fre69/voiture-rc/bras_v4_eezybot/stl_original/docs_images/b436ef58e6b25d29e519d9658bfed57a.png

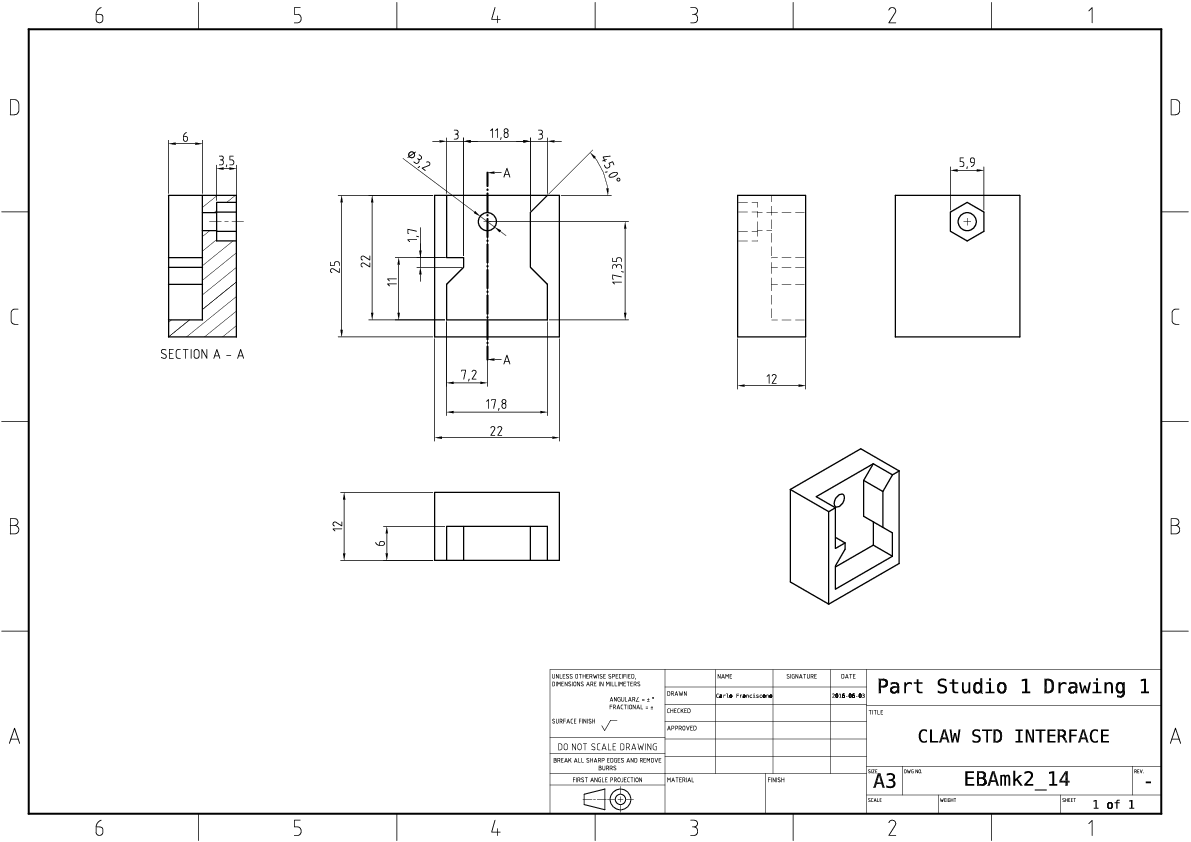
bras_v4_eezybot/stl_original/docs_images/b436ef58e6b25d29e519d9658bfed57a.png
