fre69/voiture-rc/bras_v4_eezybot/stl_original/print/EBAmk2_018_claw_gear_driven.STL

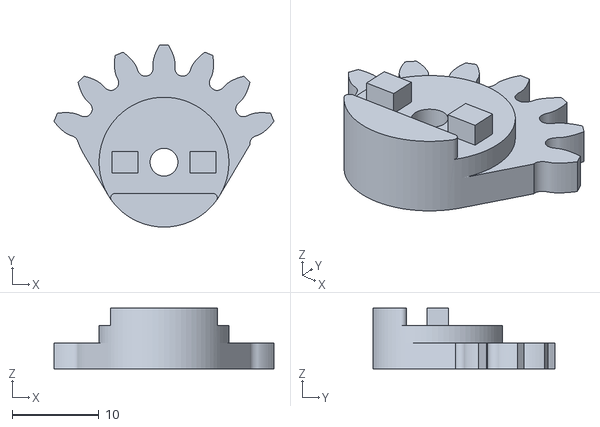
[picture p2: CAD file, 2026-04-28]
bras_v4_eezybot/stl_original/print/EBAmk2_018_claw_gear_driven.STL
25.3 x 21.0 x 7.00
