fre69/voiture-rc/bras_v4_eezybot/stl_original/skip/EBAmk2_013_lower_base.STL

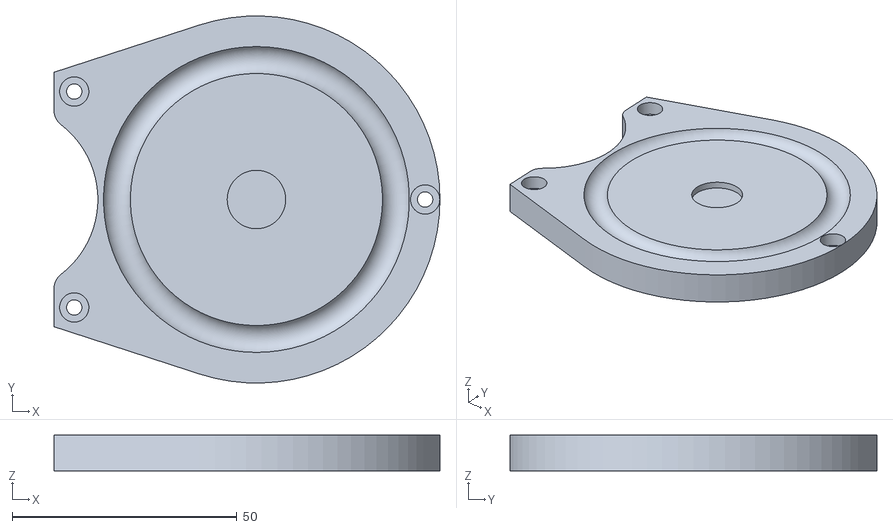
[picture p3: CAD file, 2026-04-28]
bras_v4_eezybot/stl_original/skip/EBAmk2_013_lower_base.STL
85.8 x 81.6 x 8.00
