fre69/voiture-rc/stl/biellette.stl

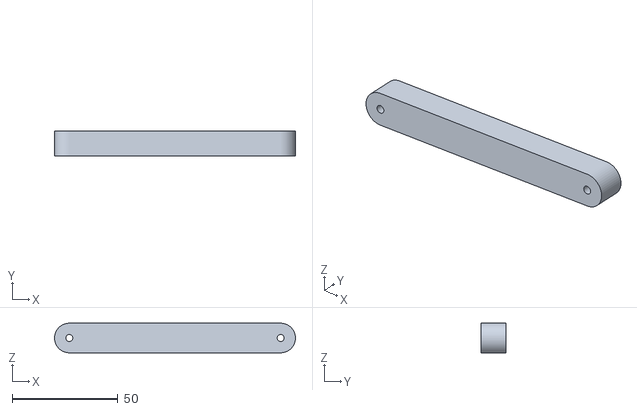
[picture p4: CAD file, 2026-04-23]
stl/biellette.stl
114.0 x 12.0 x 14.0
