fre69/voiture-rc/bras_v4_eezybot/stl_original/print/EBAmk2_016_claw_gear_drive.STL

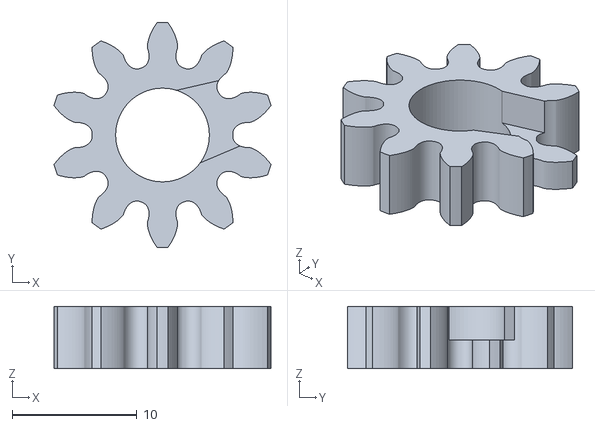
[picture p5: CAD file, 2026-04-28]
bras_v4_eezybot/stl_original/print/EBAmk2_016_claw_gear_drive.STL
17.4 x 18.0 x 5.00
