fre69/voiture-rc/bras_v4_eezybot/stl_original/skip/EBAmk2_019_drive_cover.STL

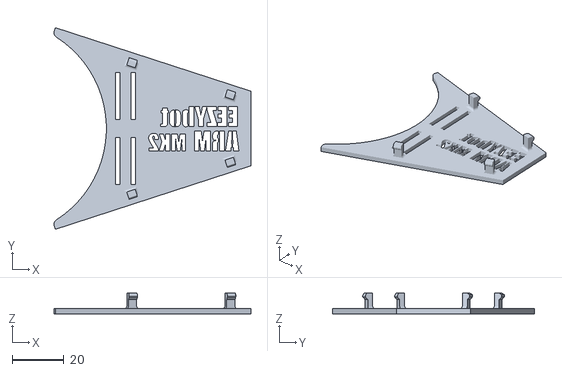
[picture p6: CAD file, 2026-04-28]
bras_v4_eezybot/stl_original/skip/EBAmk2_019_drive_cover.STL
76.3 x 78.1 x 8.00
