fre69/voiture-rc/stl/pince_corps.stl

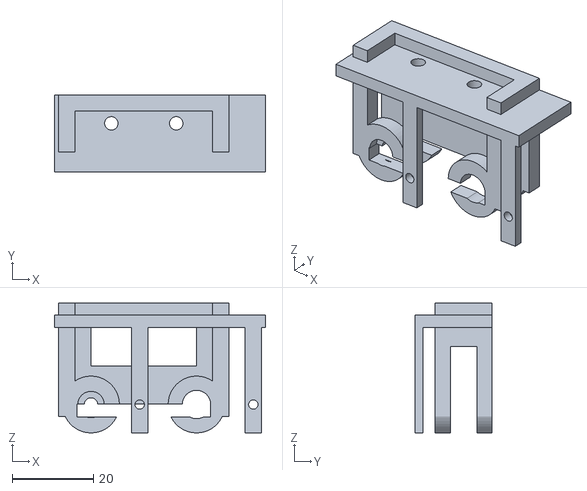
[picture p7: CAD file, 2026-04-23]
stl/pince_corps.stl
52.0 x 19.0 x 32.0
