fre69/voiture-rc/bras_v4_eezybot/stl_original/print/EBAmk2_014_claw_base.STL

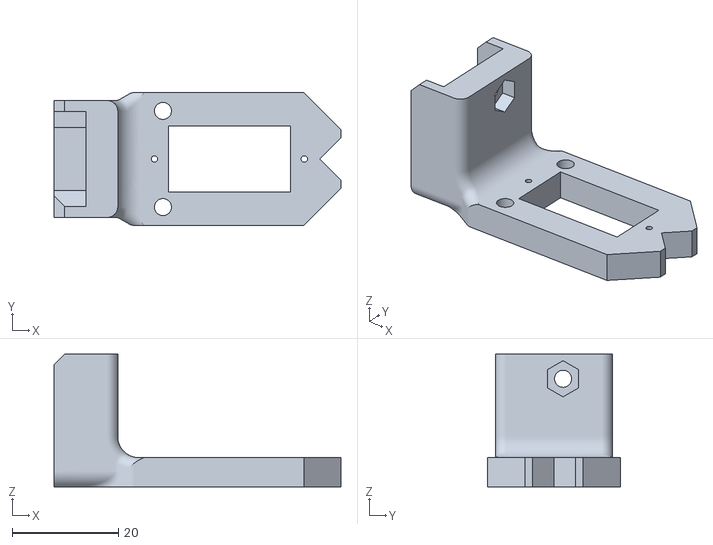
[picture p8: CAD file, 2026-04-28]
bras_v4_eezybot/stl_original/print/EBAmk2_014_claw_base.STL
54.0 x 25.0 x 25.0
