fre69/voiture-rc/stl/machoire_droite.stl

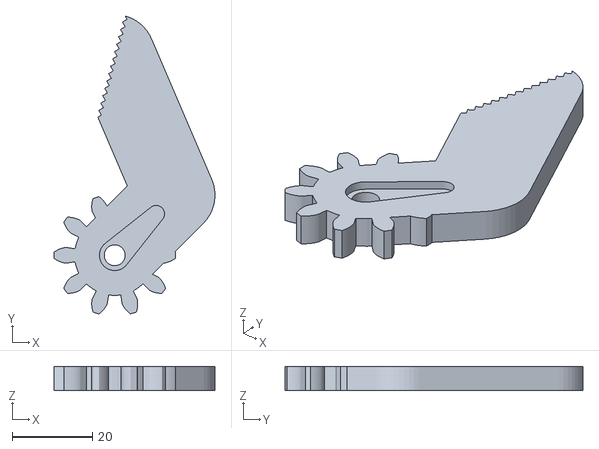
[picture p9: CAD file, 2026-04-23]
stl/machoire_droite.stl
40.1 x 74.3 x 6.00
