fre69/voiture-rc/bras_v4_eezybot/stl_original/print/EBAmk2_017_claw_finger_sx.STL

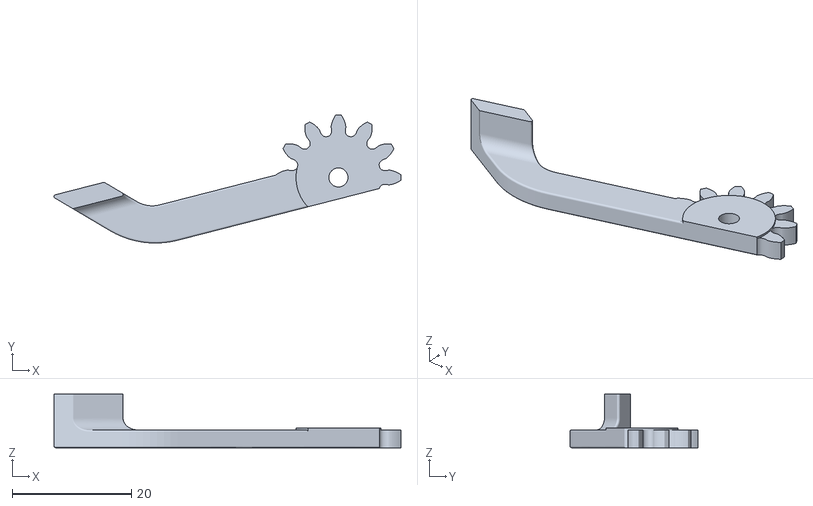
[picture p10: CAD file, 2026-04-28]
bras_v4_eezybot/stl_original/print/EBAmk2_017_claw_finger_sx.STL
58.3 x 21.5 x 9.00
