fre69/voiture-rc/stl/support_epaule.stl

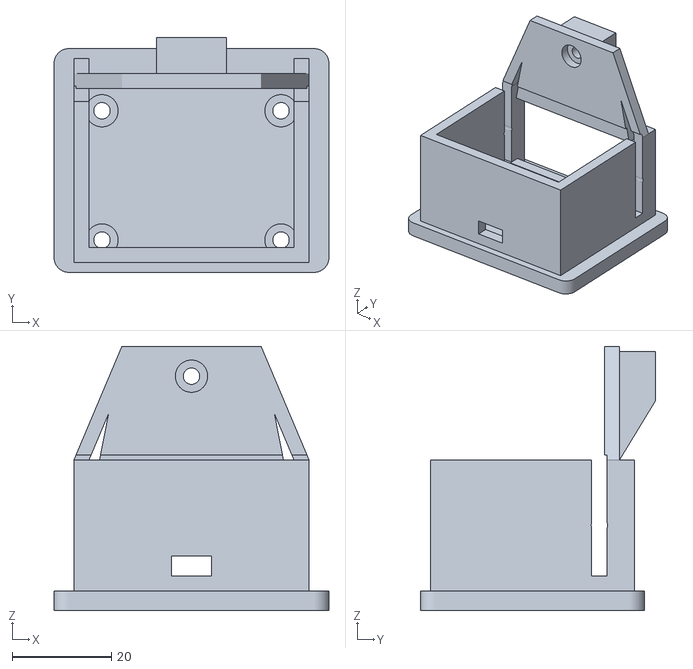
[picture p11: CAD file, 2026-04-23]
stl/support_epaule.stl
55.3 x 47.2 x 53.1
