fre69/voiture-rc/bras_v4_eezybot/stl_original/print/EBAmk2_015_claw_finger_dx.STL

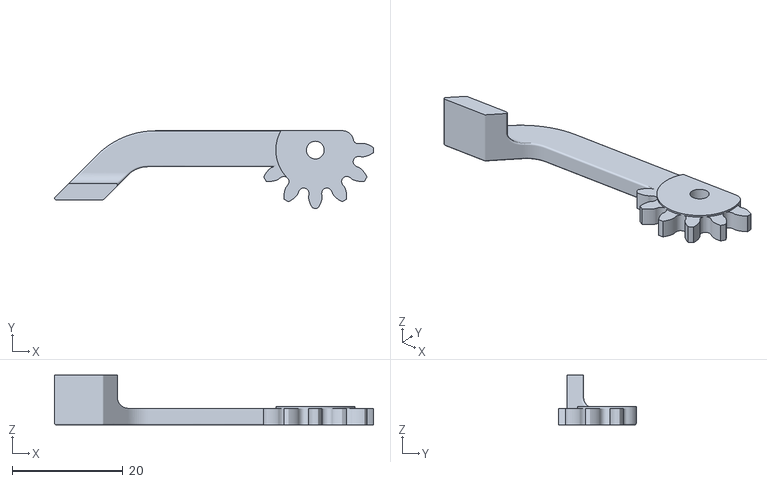
[picture p12: CAD file, 2026-04-28]
bras_v4_eezybot/stl_original/print/EBAmk2_015_claw_finger_dx.STL
57.6 x 14.0 x 9.00
