fre69/voiture-rc/stl/bras.stl

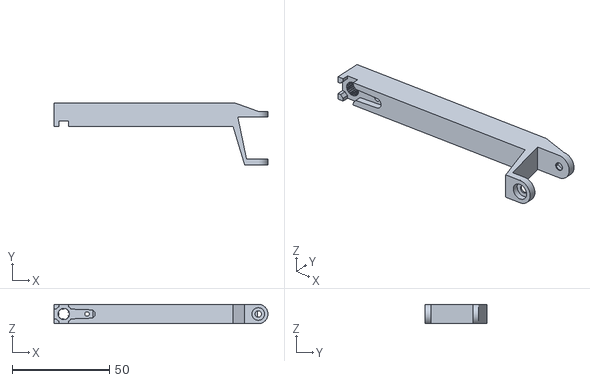
[picture p13: CAD file, 2026-04-23]
stl/bras.stl
110.0 x 31.9 x 10.0
