fre69/voiture-rc/stl/machoire_gauche.stl

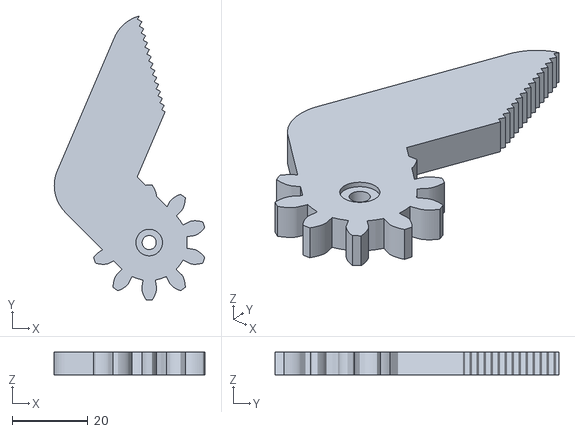
[picture p14: CAD file, 2026-04-23]
stl/machoire_gauche.stl
39.6 x 74.8 x 6.00
