fre69/voiture-rc/stl/platine_cd.stl

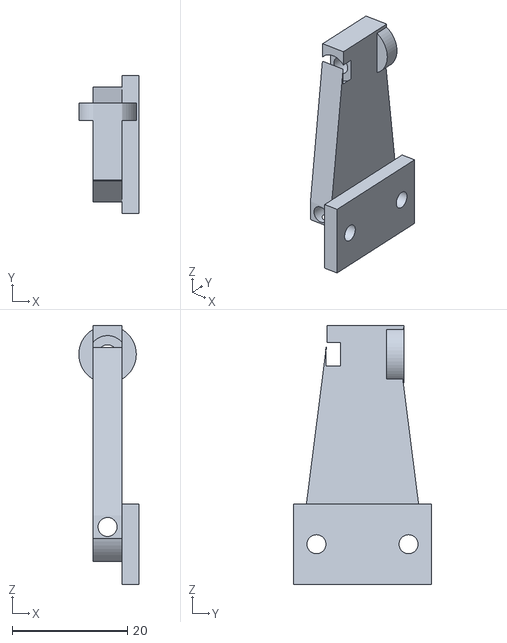
[picture p15: CAD file, 2026-04-23]
stl/platine_cd.stl
10.5 x 24.0 x 45.0
