fre69/voiture-rc/(list of files, cad)

Other CAD files:
bras_robotique_v1.scad
bras_robotique_v2.scad
archive/bras_robotique_v3.scad
