fre69/voiture-rc/bras_v4_eezybot/NOTES_ASSEMBLAGE.md

# Notes d'assemblage — journal

Fichier de suivi pendant l'assemblage. À remplir au fur et à mesure.

## Impression 3D

| Pièce | Imprimée | Temps | Remplissage | Souci ? |
|---|---|---|---|---|
| Main_Base | [ ] | | | |
| Main_Arm | [ ] | | | |
| Vertical_Arm | [ ] | | | |
| Horizontal_Arm | [ ] | | | |
| Link_1 | [ ] | | | |
| Triangle_Link | [ ] | | | |
| Servo_Horn_1 | [ ] | | | |
| Servo_Horn_2 | [ ] | | | |
| Claw_Base | [ ] | | | |
| Claw_Finger_L | [ ] | | | |
| Claw_Finger_R | [ ] | | | |
| Claw_Drive_Gear | [ ] | | | |
| support_chassis (custom) | [ ] | | | |

## Visserie reçue

| Référence | Qté reçue | Date | OK ? |
|---|---|---|---|
| Kit M4 assortiment | | | |
| Tige filetée M4×60 | | | |
| Tige filetée M4×32 | | | |
| Kit M3 (si commandé) | | | |

## Assemblage

### Étapes
- [ ] Base fixée sur plaque châssis
- [ ] Plaque châssis vissée sur voiture
- [ ] MG996R #1 installé (épaule)
- [ ] MG996R #2 installé (parallélogramme)
- [ ] Parallélogramme assemblé (biellettes + triangle)
- [ ] SG90 installé pince
- [ ] Mâchoires pince assemblées
- [ ] Câblage PWM 3 servos vers ESP32
- [ ] Premier test mouvement
- [ ] Calibration angles PWM

### Problèmes rencontrés
_(À remplir si / quand)_

### Réglages finaux
- PWM MG996R #1 (épaule) : min=___ µs / max=___ µs / centre=___ µs
- PWM MG996R #2 (parallélogramme) : min=___ µs / max=___ µs / centre=___ µs
- PWM SG90 (pince) : fermée=___ µs / ouverte=___ µs

## Photos / vidéos
_(Chemins vers fichiers ou liens)_
