fre69/voiture-rc/(commit log)

2026-04-13 Initial commit: Robot Mecanum ESP32 firmware complet (phases 1-5)
    - Manette Xbox Series via Bluepad32 (connexion, failsafe, turbo)
    - Mecanum 4 roues avec mixage omnidirectionnel + pivot LB/RB
    - Bras robotique: epaule MG996R + pince SG90
    - Anti-collision ultrason HC-SR04 x4 (axes cardinaux, round-robin)
    - Anti-collision IR x4 via PCF8574 I2C (diagonales)
    - Commandes serial: T=test moteurs, S=lecture capteurs
2026-04-13 Fix Bluepad32 PlatformIO setup + add phases 4-5 (capteurs)
    - Fix platformio.ini: use espressif32@6.13.0 + correct Bluepad32 4.1.0 URL
    - Build verified successfully (RAM 26.8%, Flash 57.1%)
    - Phase 4: HC-SR04 x4 ultrason anti-collision (round-robin, trigger partage)
    - Phase 5: Capteurs IR x4 via PCF8574 I2C (diagonales)
    - Serial commands: T=test moteurs, S=lecture capteurs
2026-04-15 Add robotic arm OpenSCAD model (v1-v3) + spec
    Bras robotique 2DOF avec parallélogramme passif pour robot Mecanum.
    - v1/v2: itérations initiales
    - v3: modèle complet avec détection de collisions colorée,
    fourche pivot C renforcée (2 flasques 3×10mm), platine CD
    effilée pour éviter la biellette, pince à engrenages
2026-04-23 Bras robotique v3 : pivots B/D cantilever + pince SG90 revue
    - Pivots B et D : passage en cantilever (bloc plein + M3 long
    + rondelle + nylstop externe) au lieu de fourches a deux flasques.
    - Jeu biellette/flasque porte a 0.8mm (fork_gap +1).
    - Platine CD : bloc pivot D integre avec taper imprimable sans support.
    - Pince corps :
    - Parois laterales symetriques (fix paroi droite trop large).
    - Passage arbre SG90 Ø7 (au lieu de Ø14 qui vidait le renfort).
    - Degagement machoires cylindrique Ø32 centre pivot.
    - Ouverture doigts elargie a la largeur interieure.
    - 2 tabs verticaux pour fixation oreilles SG90 (M2 auto-taraud.).
    - Ajout des STL exportes pour impression.
    Co-Authored-By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
2026-04-24 Archive v1-v3 bras robotique : designs abandonnés
    Les trois itérations OpenSCAD maison (v1, v2, v3) ont échoué à
    l'impression pour cause de bugs de conception :
    - arbre MG996R modélisé centré (réellement excentré ~9.8mm)
    - passage axe sur support_epaule bloque l'insertion par le haut
    - plateforme pince (24mm) plus large que la fourche bras (21.6mm)
    - platine_cd ne s'emboîte pas dans pince_corps
    Décision : repartir d'un design open-source éprouvé (cf commit suivant).
    - Déplacement des .scad v1/v2/v3 + ancienne spec vers archive/
    - Suppression des STL générés (dossier stl/) non réutilisables
    - archive/README.md : historique et raisons de l'abandon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
2026-04-24 Add bras v4 : EEZYbotARM MK2 adapté voiture Mecanum
    Remplace les designs DIY abandonnés par un design open-source éprouvé :
    EEZYbotARM MK2 par daGHIZmo (Thingiverse 1454048, licence CC BY-NC 4.0).
    Adaptations pour la voiture Mecanum :
    - Suppression de l'étage de rotation de base (la voiture pivote)
    - Économies : 1× MG996R, 1× roulement 606ZZ, 25 billes, 1× M6
    - Fichiers rotation isolés dans skip_no_rotation/ (non imprimés)
    - Plaque d'adaptation châssis : à concevoir (support_chassis.scad)
    Structure du dossier bras_v4_eezybot/ :
    - stl_original/print/ : 16 STL à imprimer (+choix horarm simple/renforcé)
    - stl_original/skip_no_rotation/ : 6 STL du sous-ensemble rotation
    - stl_or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
2026-04-28 Fix STL headers ambigus + réorganisation skip/
    Plusieurs STL daGHIZmo ont un header binaire commençant par
    "solid <nom avec espace>" (ex: "solid EBAmk2_013_lower base").
    Ce header trompe les parsers naïfs (3D Builder, Cura) qui tentent
    une lecture ASCII et signalent le fichier comme corrompu.
    Correction : réécriture des 80 octets d'en-tête pour 7 STL avec
    un identifiant propre "EEZYbotARM MK2 - <name>". La géométrie
    (comptes triangles + données) reste strictement intacte.
    Fichiers corrigés : claw_base, claw_finger_dx/sx, claw_gear_drive/driven,
    drive_cover, lower_base.
    Réorganisation dossier skip :
    - Renommé skip_no_rotation/ -> skip/ (semantique élargie)
    - Déplacé horarm__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
2026-04-28 Doc: corrige rôle de drive_cover (rotation, pas pince)
    Le 019_drive_cover est le capot du mécanisme d'entraînement de
    rotation (se clipse sur 012_mainbase pour cacher le pignon servo
    et la couronne), pas un capot esthétique de la pince comme classé
    à tort initialement. Sans rotation : rien à couvrir.
2026-05-01 Add manuel de montage adapté (EEZYbotARM MK2 sans rotation)
    Manuel pas-à-pas pour assembler le bras adapté à la voiture Mecanum.
    Reprend la structure du tutoriel Instructables daGHIZmo en sautant
    toute la section rotation de base (remplacée par fixation directe
    sur le support_chassis custom).
    Sections :
    - Pré-requis (visserie, outils, pièces)
    - Étape 0 : fixation au châssis (custom, hors manuel original)
    - Étape 1 : servos épaule + parallélogramme dans 001_base
    - Étape 2 : montage parallélogramme inférieur
    - Étape 3 : avant-bras + triangles + biellette supérieure
    - Étape 4 : pince (engrenages, SG90, doigts, fast-release)
    - Étape 5 : câblage 3 servos
    - Étape 6 : test mé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
2026-08-04 chore(vscode): couleur d'identification de la fenetre
    Barre de titre / barre d'activite / status bar colorees pour distinguer
    la fenetre de ce projet des autres ouverts en parallele.
    Couleur attribuee par C:\Users\frevi\Documents\scripts\Set-VSCodeProjectColor.ps1
    (registre vscode-couleurs-projets.json : stable dans le temps, teinte la
    moins utilisee pour tout nouveau projet).
2026-10-20 chore(vscode): couleur d'identification de la fenetre
